starryecho-T/esp32_the-helper-of-the-blinder/app/traffic_light_server/test_annotated.png

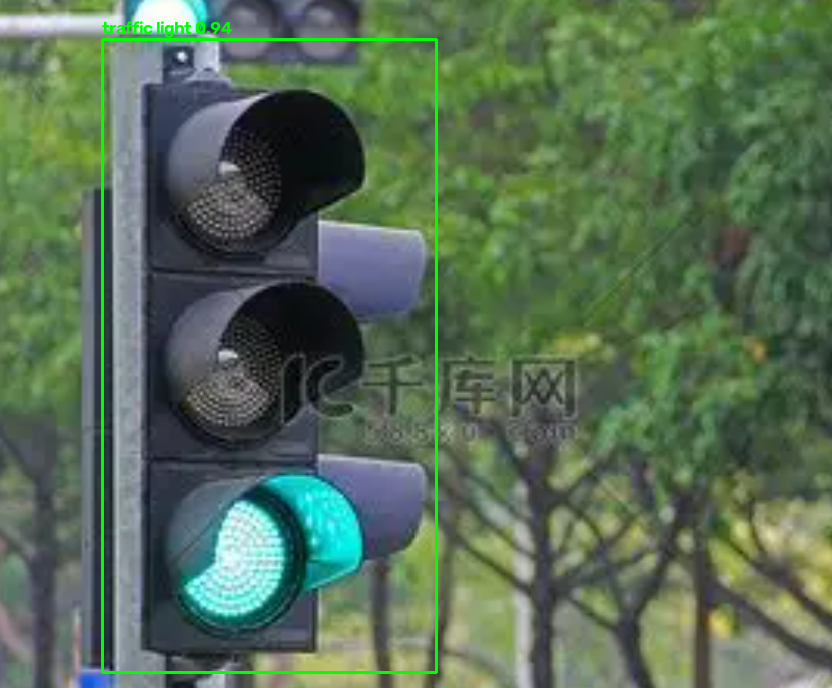
app/traffic_light_server/test_annotated.png
