starryecho-T/esp32_the-helper-of-the-blinder/app/APP_EDITING_LOCK.md

# App Inventor 编辑锁

当前编辑者：无

开始编辑 `app/current/` 中的 `.aia` 文件前，请填写编辑者、开始时间、计划修改内容和预计结束时间；完成后恢复为“无”。
