starryecho-T/esp32_the-helper-of-the-blinder/(commit log)

2026-08-10 初始项目目录结构
2026-08-11 添加各模块测试代码及BLE通信协议文档
    本次提交内容：
    1. 新增 ESP32-S3 蓝牙（BLE）基础测试代码（blueteeth_test.ino）
    - 实现设备广播、连接、收发数据的基础框架
    2. 新增 MPU6050 姿态传感器测试代码（mpu6050_test.ino）
    - 用于后续跌倒检测功能验证
    3. 新增 HC-SR04 超声波测距测试代码（ultrasonic_test.ino）
    - 用于障碍物距离检测基础测试
    4. 新增 BLE 通信协议说明文档（protocol/ble-protocol.md）
    - 记录服务UUID、特征UUID及数据格式，供App端参考
    注：以上均为独立测试文件，后续将整合到主程序中。
2026-08-30 搜索和连接蓝牙功能
2026-09-07 对于代码的修改
    之前把rx和tx搞反了，不影响代码的运行但是语义不对，这里改回来。此次更新还加入了使用app修改模式的功能
2026-09-07 代码中加入一些注释
2026-09-07 更新app的block代码
2026-09-07 上传初步的app安装包
    app实现了连接设备，在app端设置盲杖模式，显示盲杖状态信息等功能，
    电量显示和交通灯识别以及导航功能，还有报警后的二次确定尚未实现
2026-09-07 添加振动马达测试和MPU6050测试代码
    振动马达改用新版ledcWrite API，MPU6050引脚改为SDA21/SCL20
2026-09-10 增加交通灯识别后端
2026-09-10 初步实现交通灯识别
    目前已经可以实现上传一张图片然后识别交通灯颜色，还需要完成以下工作
    1、识别到不同颜色之后盲杖给出相应的反应
    2、实现识别摄像头拍的照片中的交通灯，不过我现在对摄像头拍出来的照片的清晰度保持怀疑
2026-09-11 gps,tts,前哨基础功能调试
    基础功能分开调试
2026-09-12 上传新的服务器和app,初步实现自动识别摄像头照片
2026-09-12 上传新的服务器和app
    实现了识别摄像头拍的照片的功能，此版本的各种ip基于我的手机的热点
2026-09-17 修改
    111
2026-09-18 111
    111最后一次
2026-09-18 Update 演示说明.md
    1
2026-09-21 实现云端红绿灯识别
2026-09-21 实现远程查看摄像头画面
2026-09-24 feat(app): WebApp 重构落地 + 双端 APK 壳工程（Actions 云编译）
    - app/webapp: 零依赖纯静态 WebApp（盲人端+家属端，协议 37/37 单测通过）
    - app/android/apk-blind: 智慧盲杖 APK（WebView + 原生 BLE 桥，WebView 不支持 Web Bluetooth 由 Java NUS 实现扫描/连接/收发）
    - app/android/apk-family: 智慧盲杖·家属端 APK（WebView 轮询+地图）
    - ble.js: 检测 SmartCaneNative 注入自动切换原生桥/浏览器 Web Bluetooth 两栖
    - .github/workflows/build-apk.yml: push 自动云编译两个 APK（产物在 Artifacts 下载）
    注: server.py 的 CORS 修改在工作区未提交（该文件另有既有改动，由维护者确认后一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
2026-09-24 fix(server): CORS 放开跨域 + FRAME_MAX_AGE 45s 适配 30s 推流
    - CORSMiddleware(allow_origins=*): 手机 WebApp/APK fetch /detect /snapshot 需要跨域响应头（App Inventor 原生 HTTP 不受影响）
    - FRAME_MAX_AGE 20->45: 必须大于前哨固件 30s 推流间隔，否则帧龄 20~30s 时 /detect、/snapshot 误报帧过期
2026-09-24 feat: 去Firebase化——双端通信改走自有服务器 /fb 接口
    - server.py 新增 /fb/{node}/{key}.json (PUT/GET) 与 /fb/{node}.json (GET)，
    REST 格式与 Firebase RTDB 兼容，前端零改动
    - webapp config.js: firebase.baseUrl 指向 http://39.106.216.80:8000/fb
    - deploy.ps1: FRAME_MAX_AGE 提升为 45s
    - 前哨固件 scout_cam_cloud 入库（Stream 分块上传修复 HTTP -3）
    [Scout_CAM_Cloud_ESPNOW_Traffic.ino]
2026-09-24 chore(apk): 同步 config.js 到双端 APK assets（去Firebase化配套）
    5234c7f 将 webapp 的 firebase.baseUrl 指向自建 /fb 接口，
    但两个 APK assets 内的 config.js 副本未同步，仍指向
    境外 Firebase RTDB——新构建的 APK 双端通信（GPS 上传/
    家属轮询）会继续走 Firebase，等于白改。
    用 app/webapp/js/core/config.js 覆盖：
    - app/android/apk-blind/app/src/main/assets/webapp/js/core/config.js
    - app/android/apk-family/app/src/main/assets/webapp/js/core/config.js
2026-09-25 实现自动重连
2026-09-26 feat(barrier): 障碍物检测全链路——云端 yolov8s /barrier 接口 + App 解析播报并回传盲杖
2026-09-26 fix(apk): 修复 BLE 扫描遇无广播名设备时 NPE 闪退 + 兼容 Android<=12 通知回调
    真机 logcat 定位（一加 PLF110 / Android 16，今日 3 次同堆栈）：
    BleBridge.onScanResult 第204行 name.toLowerCase() 对 null 设备名调用 -> FATAL NPE。
    周围常有无广播名 BLE 设备（耳机/手环/信标），getName() 合法返回 null，safeName 只拦 SecurityException。
    修复：
    1. 名字前缀判空空安全（主修复）
    2. 补 API<=32 的两参 onCharacteristicChanged 旧签名重写（否则旧系统连得上但收不到数据）
    3. startScan 入口校验三个 UUID，非法时友好报错而非服务发现阶段抛 IllegalArgumentException
2026-09-27 fix(app): 补绑模式按钮 click 事件，修复无法切换安静/日常/夜间模式
    setMode() 此前只定义未接线，连接后按钮可点但无任何反应，不发送 MODE:0/1/2 指令；同时同步 apk-blind / apk-family 内嵌 webapp 副本保持一致。
2026-09-27 fix(ble): 状态包分片发送 + App 脏行防护，修复障碍物栏偶显 MODE 乱码
    根因：固件 sendBLE 一次性 notify 约 140 字节状态包，超 BLE 单通知上限（MTU-3）时被截断丢字节；App 按 \n 重组行后相邻字段错位拼接（如 TYPE:MODE:0），障碍物栏兜底显示原始脏值。
    - firmware: sendBLE 按 20 字节分片发送（任何 MTU 下安全），片间 delay 6ms 防拥堵（需重新烧录）
    - app(三处同步): protocol.js parseStatus 增加 TYPE 白名单校验，非法整行丢弃；normalizeMode 未知值不再透传，界面保持上一有效值
    [main.ino]
2026-09-27 docs: 修正推流间隔的陈旧注释（1.2s/30s → 2s，与 UPLOAD_INTERVAL_MS 对齐）
    [espnow_sender.ino]
2026-09-27 feat(app): 盲人端底部新增手动灯色按钮，一键向盲杖回传红/黄/绿灯色
    - blind.html 底部新增「手动灯色（演示）」卡片：红/黄/绿三个大按钮，未连接 BLE 时置灰
    - app.js 新增 sendManualLight()：点击即通过 BLE 发送 RED/YELLOW/GREEN，盲杖 setTrafficLight() 语音播报；页面灯色框同步显示 + 本地 TTS 播报
    - 三个按钮纳入 BLE 连接状态联动（连接启用/断开禁用）
    - app.css 补 .btn-warning 黄色样式与 .btn-grid-3 三列网格
    - 云端识别不可用时的演示兜底，不改变原识别闭环
2026-09-27 feat(app): 手机端依据 BLE 事件代读语音播报（纯软件，无需烧录）
    - blind/app.js 新增 announce() 统一播报入口（同一句 3 秒去重，防重复朗读）
    - MODE/FALL/ALARM 事件与 BATT<20 低电量触发手机 TTS，文案与原 SYN6288 一致
    - FALL:1 每 3 秒重发，一次跌倒只播一遍；低电量与固件同阈值、一次性播报
    - protocol.js 保留 SAY: 解析（休眠预留，未来固件支持即自动生效且不双播）
    - README 补充「手机代读语音」功能说明
2026-09-27 fix(app): 修复移动端语音代读无声——手势解锁 + 测试按钮 + 失败上报
    iOS Safari / 微信内置浏览器等要求 speechSynthesis 首次 speak 必须在
    用户手势内调用，否则蓝牙事件触发的后台播报被静默吞掉。
    - tts.js 新增 unlock()（幂等）：页面首次触摸/点击自动解锁
    - blind.html 新增「测试语音」按钮：手动自检 + 强制解锁
    - tts.speak() 挂 onerror：失败原因（not-allowed 等）toast 上报页面
2026-09-27 feat(app): 语音播报新增预录音频兜底，修复不支持 speechSynthesis 的浏览器无声
    微信内置浏览器/部分国产内核不带 speechSynthesis，在线合成不可用。
    - audio/ 新增 13 条预录 WAV（Windows Huihui 生成，共约 1.6MB）：
    模式×3/报警/低电量/跌倒/灯色×4/障碍×2/语音测试
    - tts.js：不支持在线合成或合成失败（onerror）时自动改播对应预录音频；
    障碍摘要为动态文本，按「前方障碍：」前缀匹配通用提示音
    - 「测试语音」按钮兼容提示：不支持在线合成时改播预录音频
    - README 补充语音三重保障说明
2026-09-27 ci: APK 打包同步 webapp/audio 预录音频目录
2026-09-28 feat(webapp): 长按双检交通灯+障碍物，障碍播报具体名称
    - 盲杖按钮长按(CAMERA:CAPTURE/barrierdetect)与页面按钮长按1秒触发同一双检：
    同时请求 /detect + /barrier，单路失败不影响另一路
    - 播报规则：未识别到交通灯不播报；无障碍不播报；有障碍播具体名称
    (COCO label→中文，未收录回退4大类)，界面同步显示具体名与置信度
    - 页面识别按钮改长按1秒防误触(不足1秒提示)，屏蔽移动端长按系统菜单
    - tts.js 新增 speakSequence 分段播报：在线合成排队读；预录环境自动把
    前方障碍：行人、狗拆成 barrier-intro+类词 WAV 链播(新录30条，Huihui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
2026-09-30 项目结束
    Added project completion announcement and award information.
